seasaltsaige/popup-wink-mod/README.md

# Winkduino Headlight Controller

This project aims to be a "replacement" for the [MX-5 Tech](https://mx5tech.co.uk/wink-sleepy-eye-mod) Wink/Sleepy Eye mod. While, for most people, simply purchasing this product is the correct choice, as it is plug and play, this will aim to achieve the same result at a lower cost, but a bit more effort, though this reposity serves as a detailed guide on how to install the device in your own car, hopefully removing a lot of the difficulty. Plus it's a fun build :)

## See [OpenWink](https://github.com/seasaltsaige/openwink) now!

### DISCLAIMER:
This will modify, cut, and replace some of the cars wiring harness in the headlight motors. It is reversable, but not to 100% OEM standards. Do this at your own risk. I am not responsible for any damage you cause to your car or yourself.

This project will involve solder fumes. These are dangerous to inhale. Wear a mask and eye protection while soldering, and do it in a well ventalated area.

# Table of contents
[Getting Started](https://github.com/seasaltsaige/popup-wink-mod/blob/master/build/Home.md)

[Programming your Arduino](https://github.com/seasaltsaige/popup-wink-mod/blob/master/build/Code/Arduino/Programming.md)

[Installing your control App](https://github.com/seasaltsaige/popup-wink-mod/blob/master/build/Code/App/Installing.md)

[Start Building](https://github.com/seasaltsaige/popup-wink-mod/blob/master/build/Build/Home.md)

### [Check out the Gallery](https://github.com/seasaltsaige/popup-wink-mod/tree/master/build/images/Gallery/Gallery.md)
