seasaltsaige/popup-wink-mod/build/images/Materials.jpg

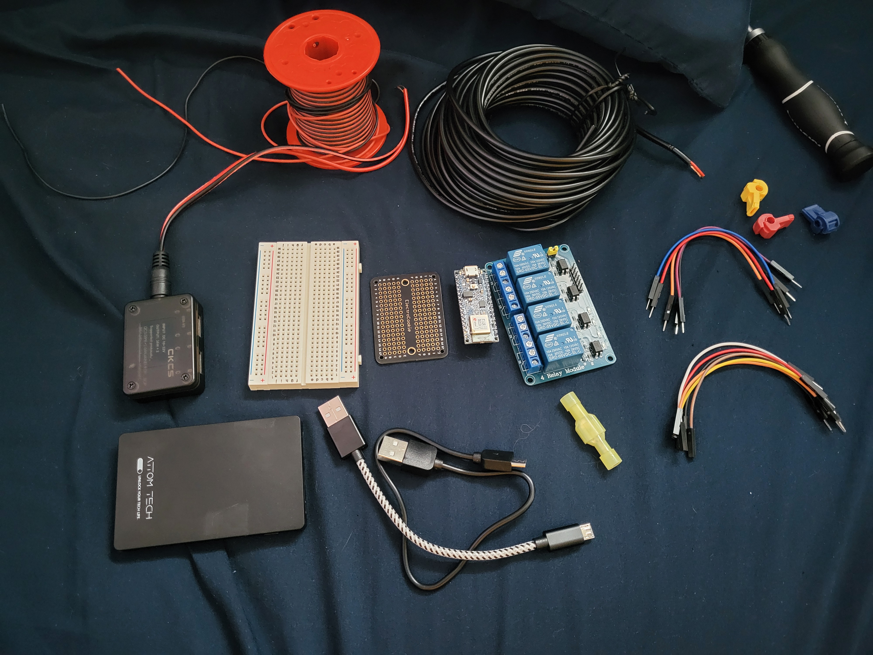
build/images/Materials.jpg
