seasaltsaige/popup-wink-mod/build/images/Gallery/Gallery.md

# Gallery
## App
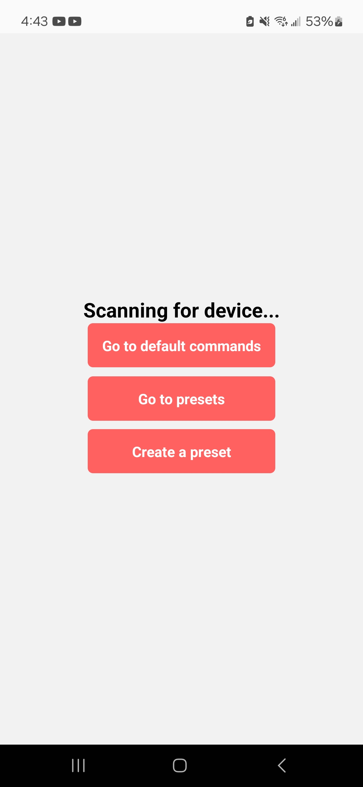
[picture p41: build/images/Gallery/ScanningHome.jpg]
HomeDisconnected

Landing page of the app. Displayed when no device is connected.

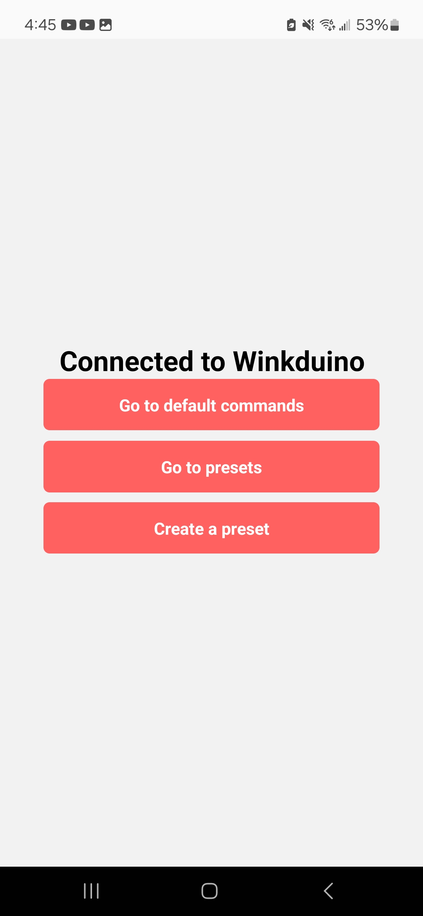
[picture p42: build/images/Gallery/HomeConnected.jpg]
HomeConnected

Landing page of the app. Displayed when Winkduino is connected.

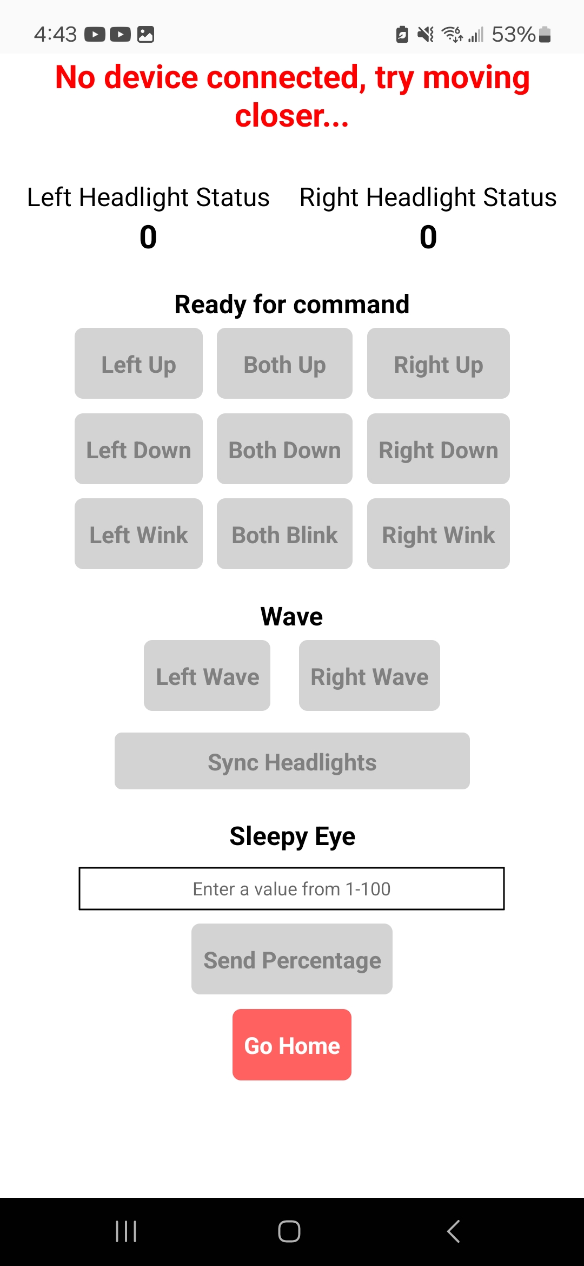
[picture p43: build/images/Gallery/NotConnectedDefault.jpg]
DefaultDisconnected

Default Commands when device is not connected

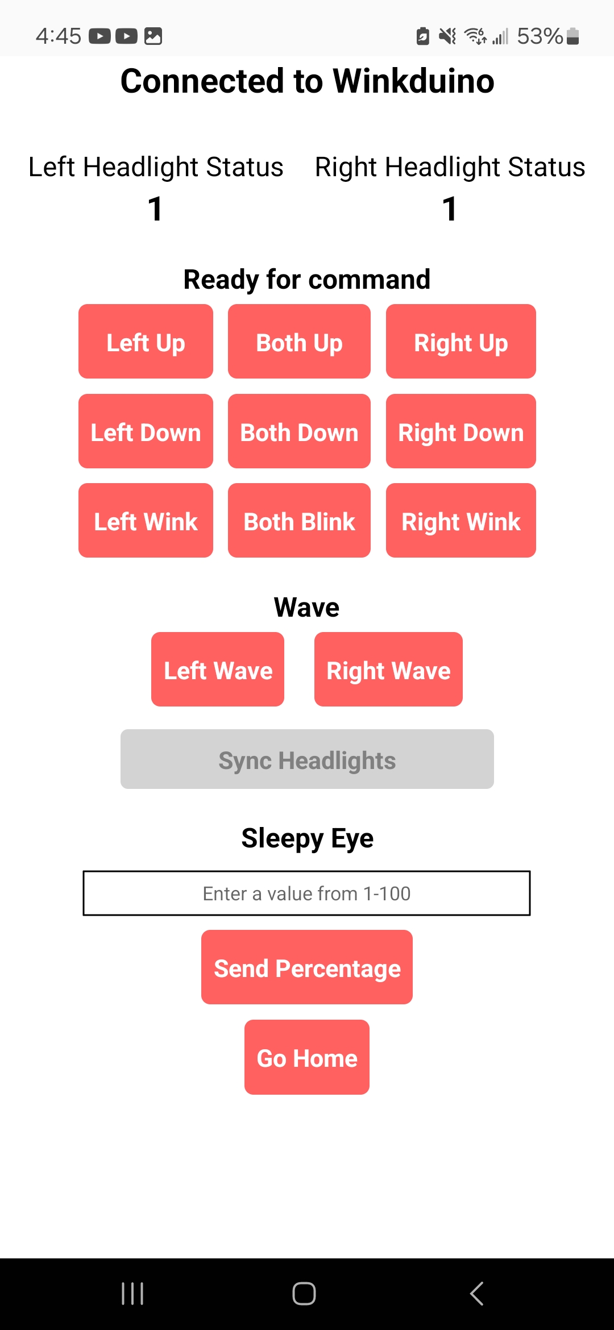
[picture p44: build/images/Gallery/DefaultConnected.jpg]
DefaultConnected

Default Commands when device IS connected

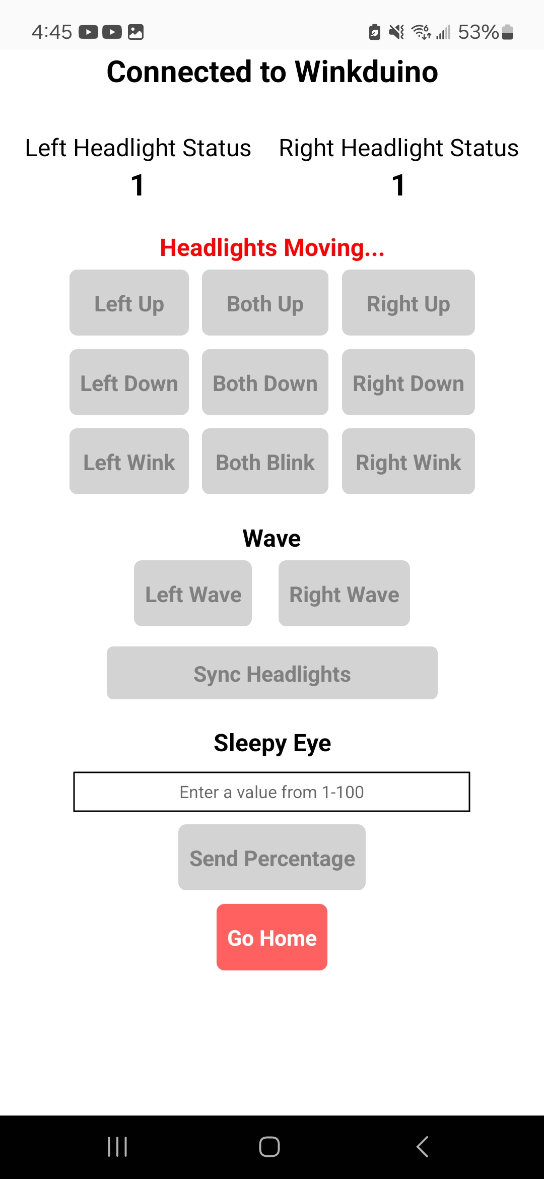
[picture p45: build/images/Gallery/DefaultMoving.jpg]
DefaultMoving

Default commands when headlights are moving

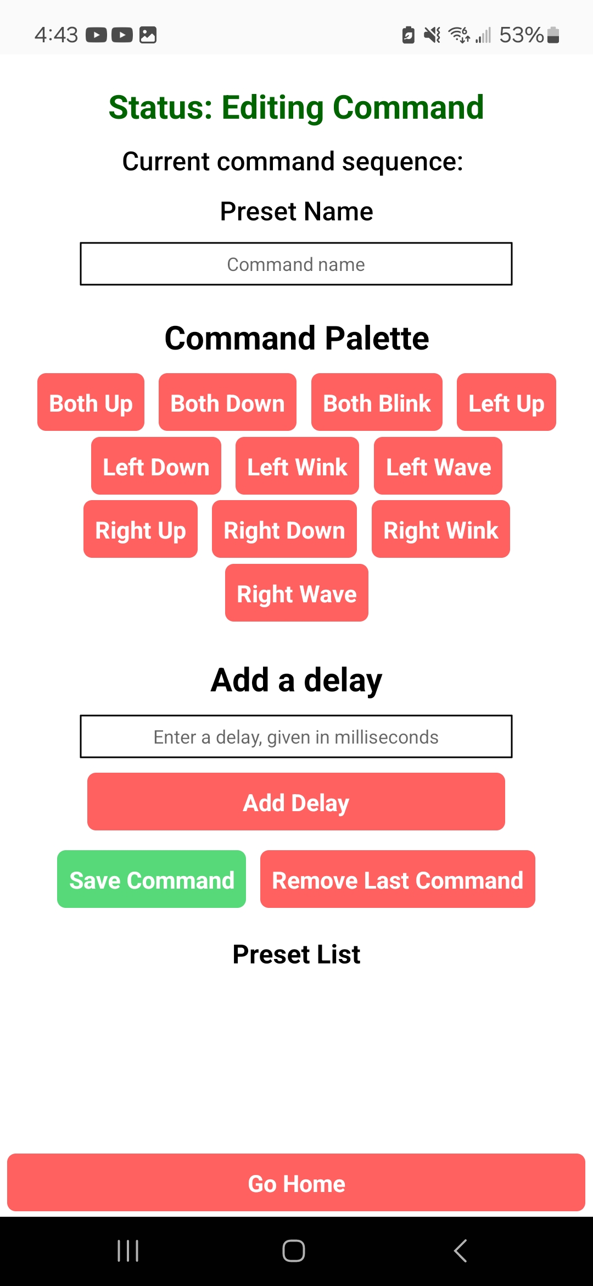
[picture p46: build/images/Gallery/CreatePresetEmpty.jpg]
CreatePreset

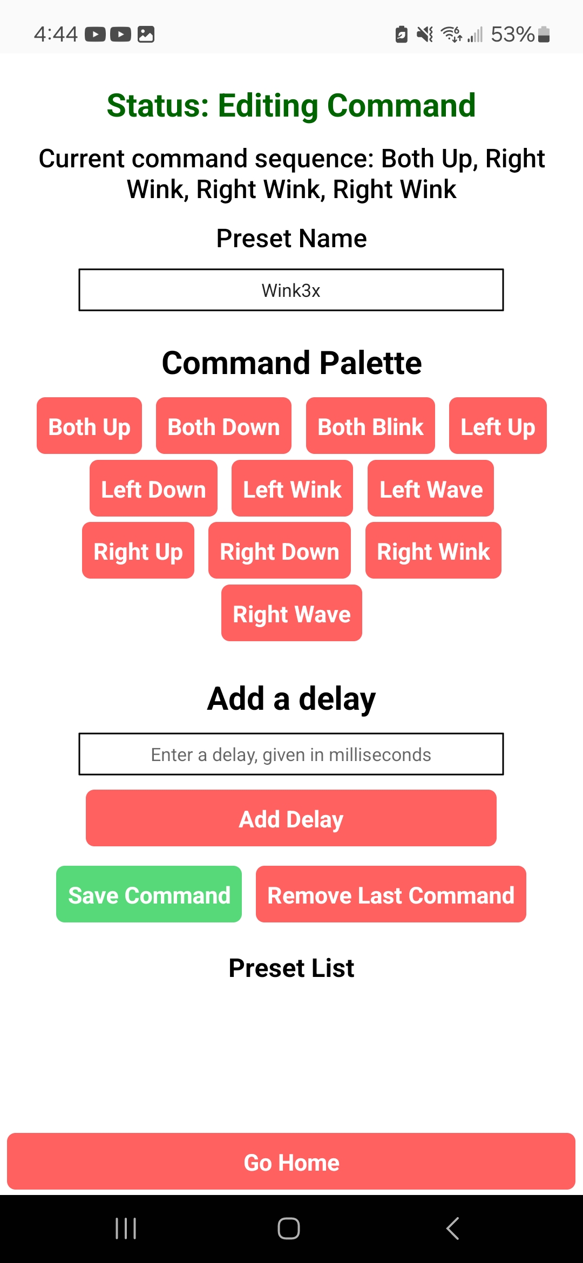
[picture p47: build/images/Gallery/CreatePresetFilled.jpg]
CreatePreset2

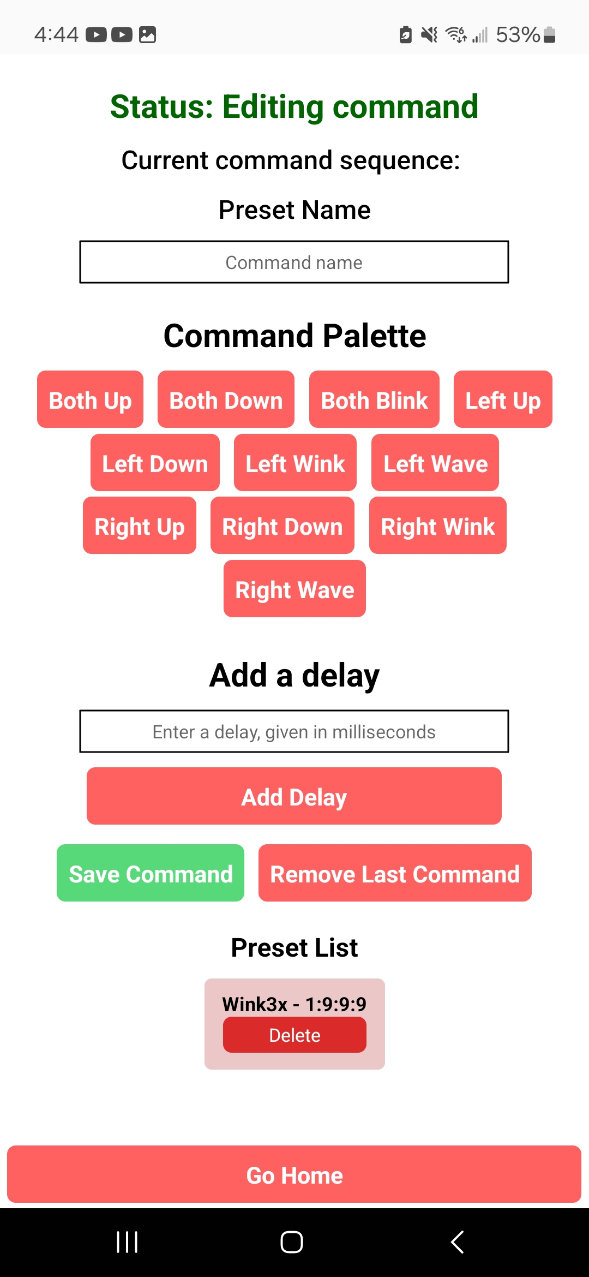
[picture p48: build/images/Gallery/PresetCreated.jpg]
CreatePreset3

Creating a preset, to be used as a shortcut, instead of pressing multiple default commands.

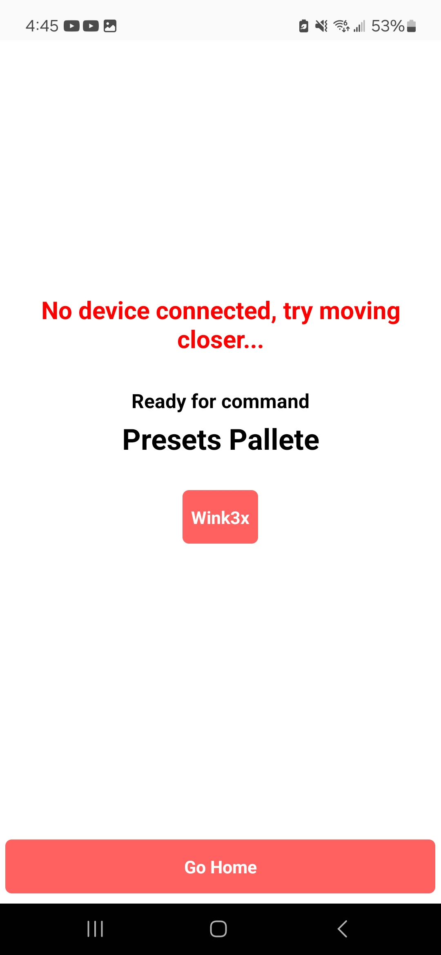
[picture p49: build/images/Gallery/PresetsNotConnected.jpg]
PresetsDisconnected

Presets pallete with no connection
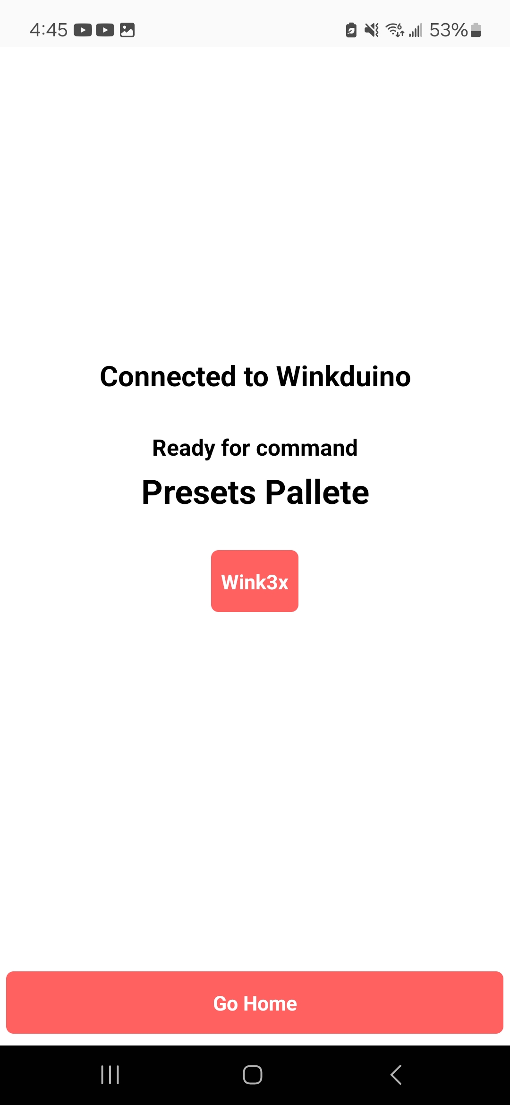
[picture p50: build/images/Gallery/ConnectedPresets.jpg]
Presets

Presets List

## Car
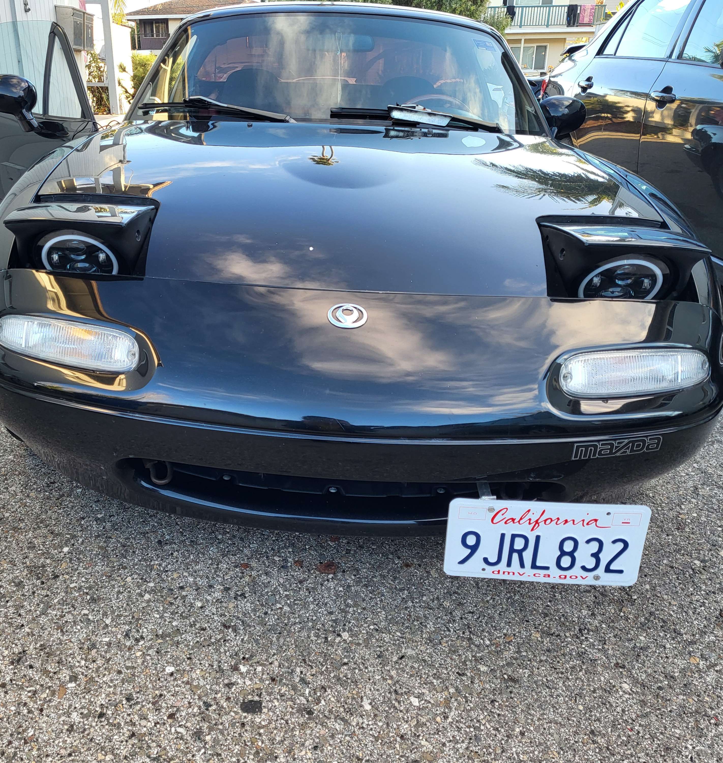
[picture p51: build/images/Gallery/Sleepy.jpg]
Sleepy


Wink
