seasaltsaige/popup-wink-mod/build/Code/Arduino/Programming.md

# Programming your Arduino

## Table of contents

- [Installing the Arduino IDE](#installing-the-arduino-ide)
- [Uploading the code](#uploading-the-code)
  - [Download](#download)
  - [Connection](#connection)
  - [Code overview](#code-overview)
    - [Download](#download-the-code)
    - [Modification](#modifying-the-code)
  - [Uploading to Board](#uploading-the-code)

## Installing the Arduino IDE

First, you will need to install the IDE that arduino provides. You can do so [here](https://www.arduino.cc/en/software)
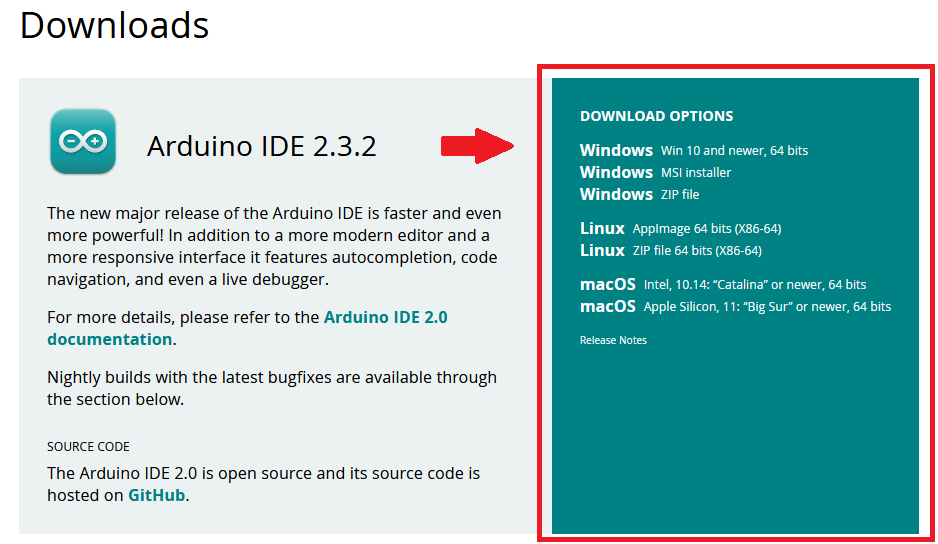
[picture p52: build/images/Arduino/Download.png]
IDE Download


## Connection
Once you have the IDE installed and open, you can go ahead and connect your Arduino to any USB port. The Arduino uses Micro USB-B as its connection.
The IDE should automatically detect it, and assign the correct COM port.
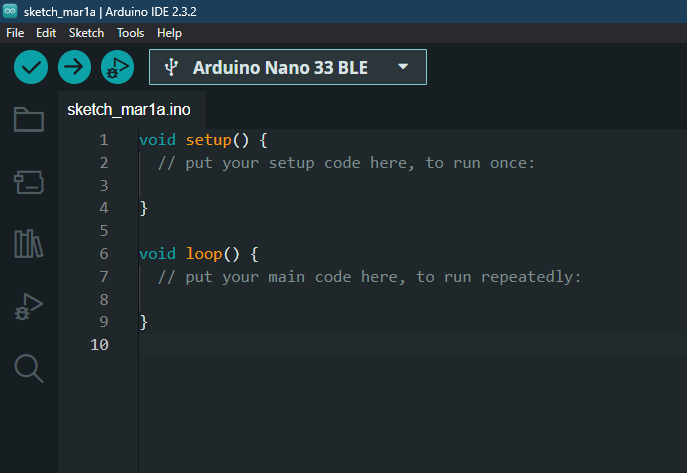
[picture p53: build/images/Arduino/IDE_1.png]
COM PORT


If it doesn't, you open the dropdown and select the Arduino. Make sure the COM Port is correct, otherwise the upload will fail.
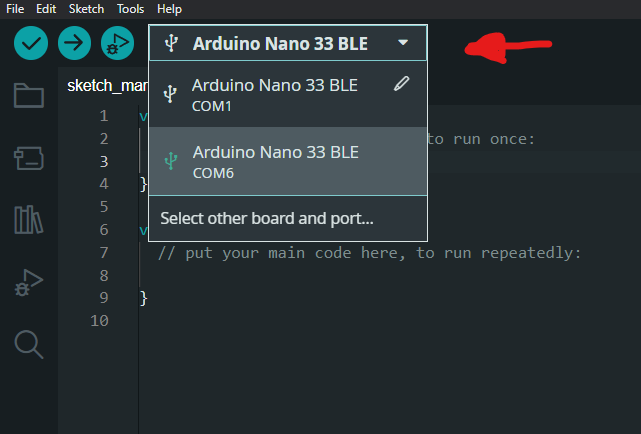
[picture p54: build/images/Arduino/IDE_2.png]
Selction


## Code overview

### Download the Code
To download the script that will be the main brains behind controlling the headlights, head to the [nano_ble](https://github.com/seasaltsaige/popup-wink-mod/blob/master/nano_ble/winkduino/winkduino.ino) folder, and click on the .ino file. In the top right of the code, there will be a "download raw" button. Download the file and save it to a folder with the same name as the file. (The IDE requires this.)

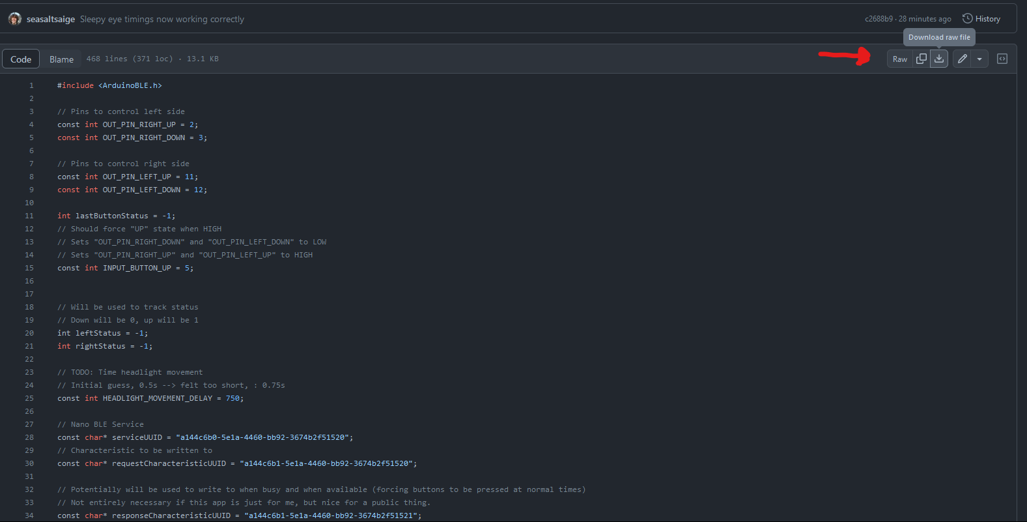
[picture p55: build/images/Arduino/DownloadCode.png]
Download Script


Once you have the script downloaded in its own folder, you can selected **File -> Open** in the Arduino IDE. Select the folder you just made.
You should be greeted with something along the lines of this.

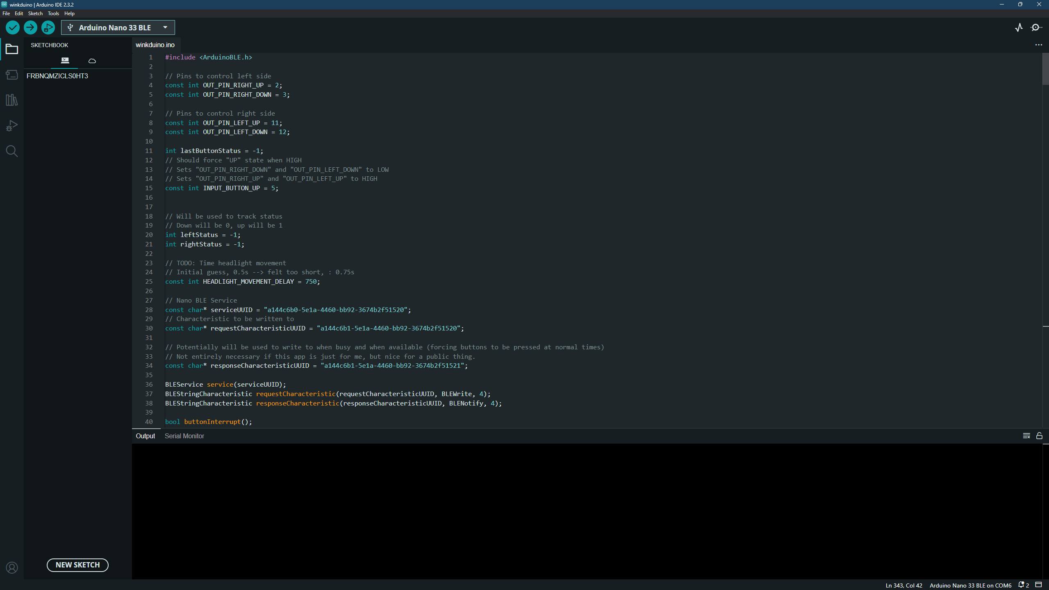
[picture p56: build/images/Arduino/MainCode.png]
Main Code


Well done! You're getting there.

Now we need to make sure that the ArduinoBLE library is installed, otherwise the program will not function.

On the left side of the IDE, you can click on the library manager, and search for "ArduinoBLE". Install this library.

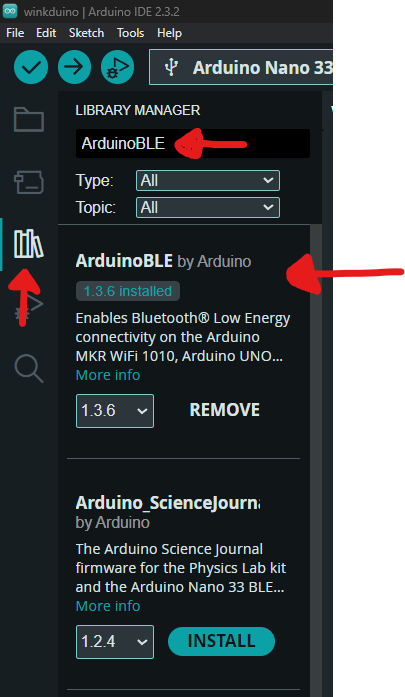
[picture p57: build/images/Arduino/BLELibrary.png]
BLE Library


Almost there!

### Modifying the code
If you feel you can, feel free to change the code however you see fit. Change the delays, change the pins used, change the whole thing if you want. This should serve as a starting point to make customizing it easy! (If you are able to modify this on your own, you likely don't need to be following the installation of the program on the arduino, and/or the App, so feel free to skip to the [Build Process](https://github.com/seasaltsaige/popup-wink-mod/tree/master/build/Build/Home.md))

## Uploading the code
Once you're ready, we can go ahead and upload the code to the arduino. To do this, all you need to do is press the right arrow in the top left of the screen.

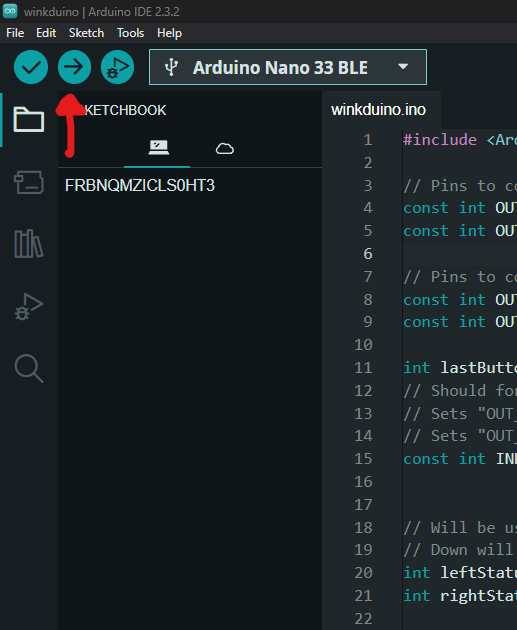
[picture p58: build/images/Arduino/UploadCode.png]
Upload


Congrats! Arduino programmed!

### [Go to App Installation -->](https://github.com/seasaltsaige/popup-wink-mod/tree/master/build/Code/App/Installing.md)
