seasaltsaige/popup-wink-mod/build/images/Build/Car/RadioConnector.jpg

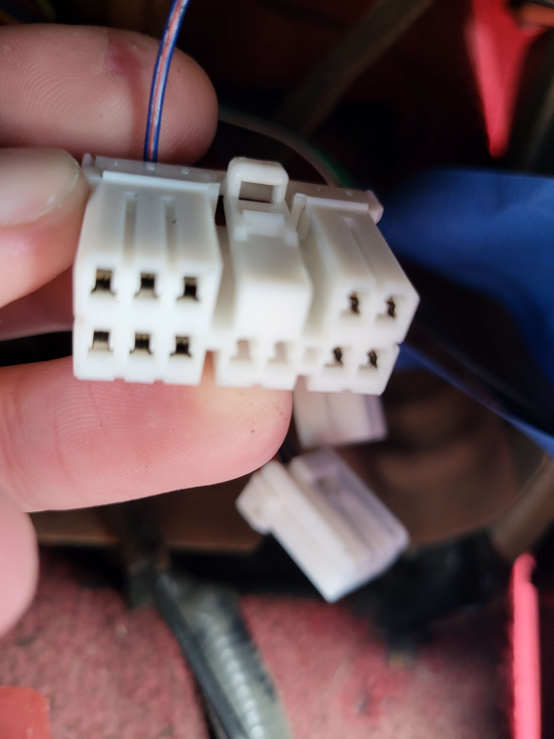
build/images/Build/Car/RadioConnector.jpg
