seasaltsaige/popup-wink-mod/build/images/Build/NanoBB.jpg

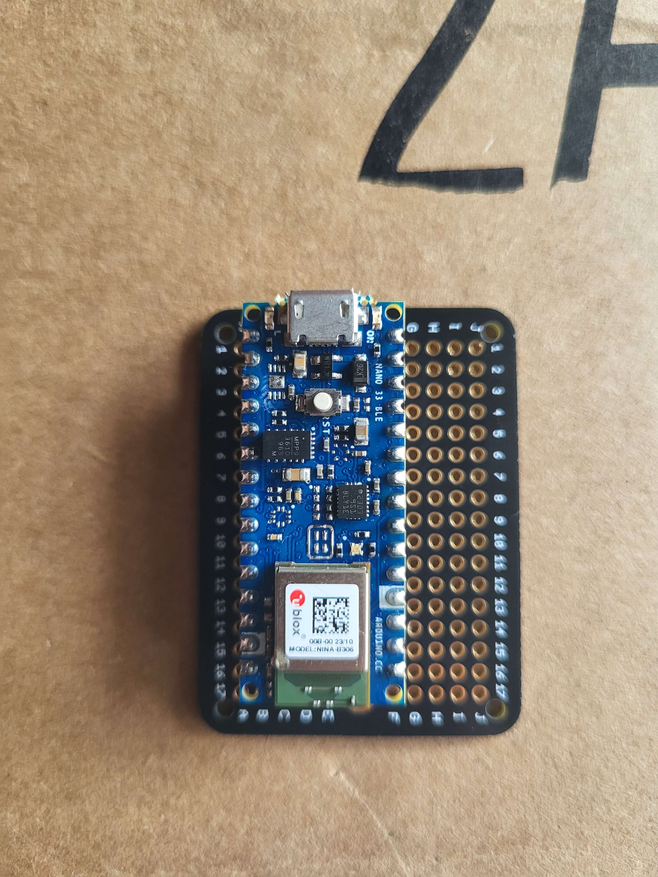
build/images/Build/NanoBB.jpg
