seasaltsaige/popup-wink-mod/build/images/Connectors.jpg

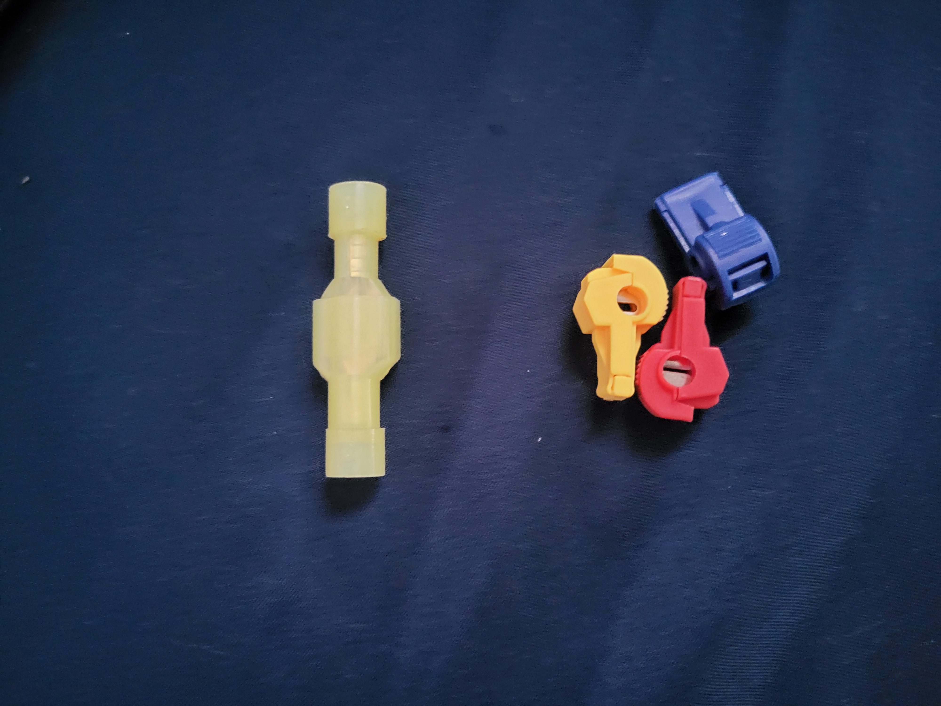
build/images/Connectors.jpg
