seasaltsaige/popup-wink-mod/build/images/Gallery/ScanningPresetsEmpty.jpg

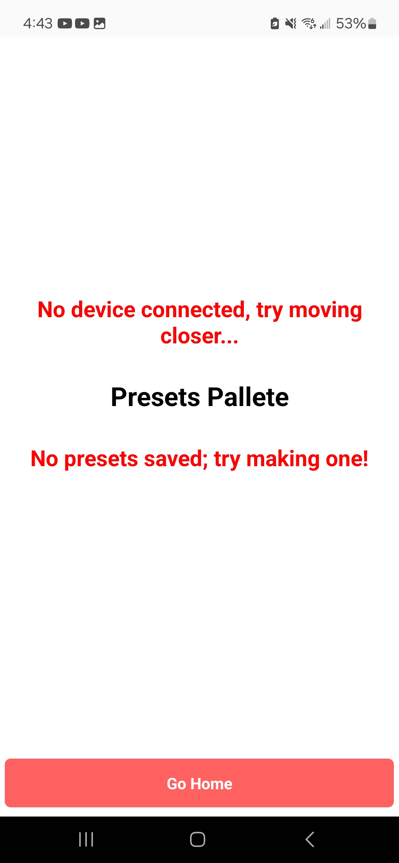
build/images/Gallery/ScanningPresetsEmpty.jpg
