seasaltsaige/popup-wink-mod/build/images/SolderlessBB.jpg

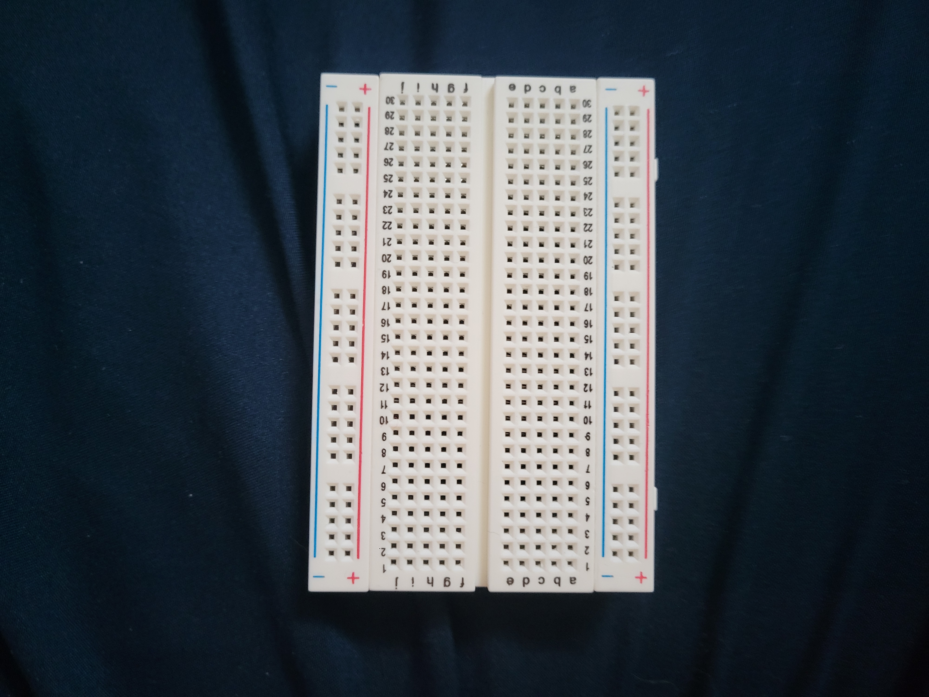
build/images/SolderlessBB.jpg
