seasaltsaige/popup-wink-mod/build/images/WIres1.jpg

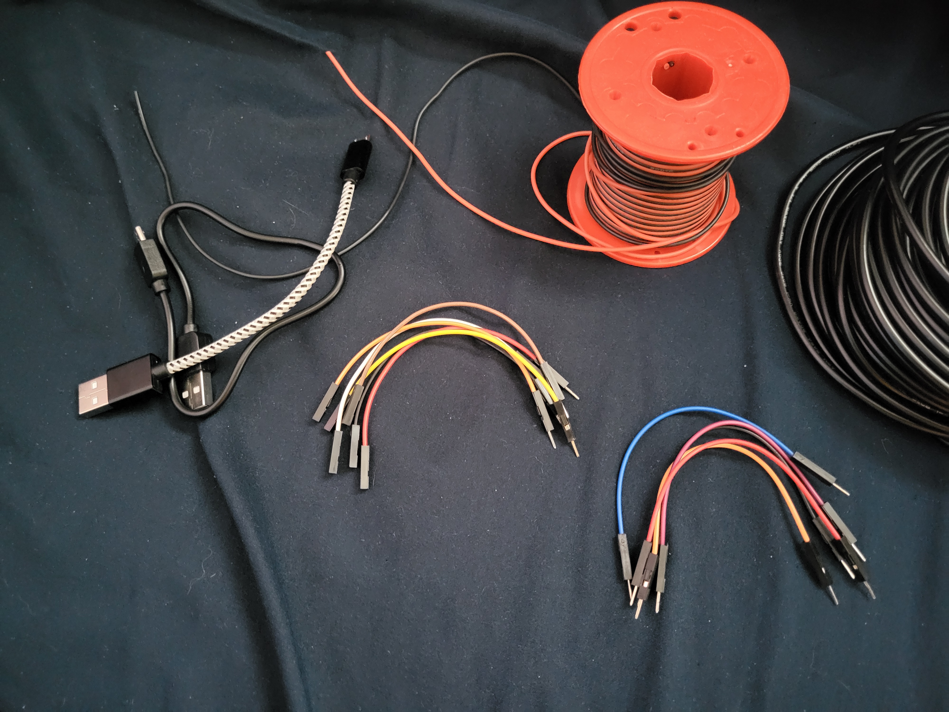
build/images/WIres1.jpg
