seasaltsaige/popup-wink-mod/(commit log)

2024-02-24 Boiler plate code + update to readme
2024-02-26 Nano Code work. Can't test until board arrives
2024-02-28 Work done on arduino code. Still waiting on board
2024-02-28 Update syncHeadlights to account for main button. Added case for potential sleepy eyes
2024-02-29 Major work on app side. Development build ready for testing when arduino arrives
2024-03-01 Massive work done on arduino code. Most works at this moment.
2024-03-01 swapped pin values as they were backwards
    [winkduino.ino]
2024-03-01 Work on sleepy eye, but relays are not cooperating
2024-03-01 Sleepy eye timings now working correctly
    [winkduino.ino]
2024-03-01 Got sleepy eye reset working, as to avoid destroying motors
    [winkduino.ino]
2024-03-03 radio wiring harness docs
2024-03-08 Update materials
2024-03-10 Presets on arduino end working
