seasaltsaige/popup-wink-mod/build/images/CatBreak2.jpg

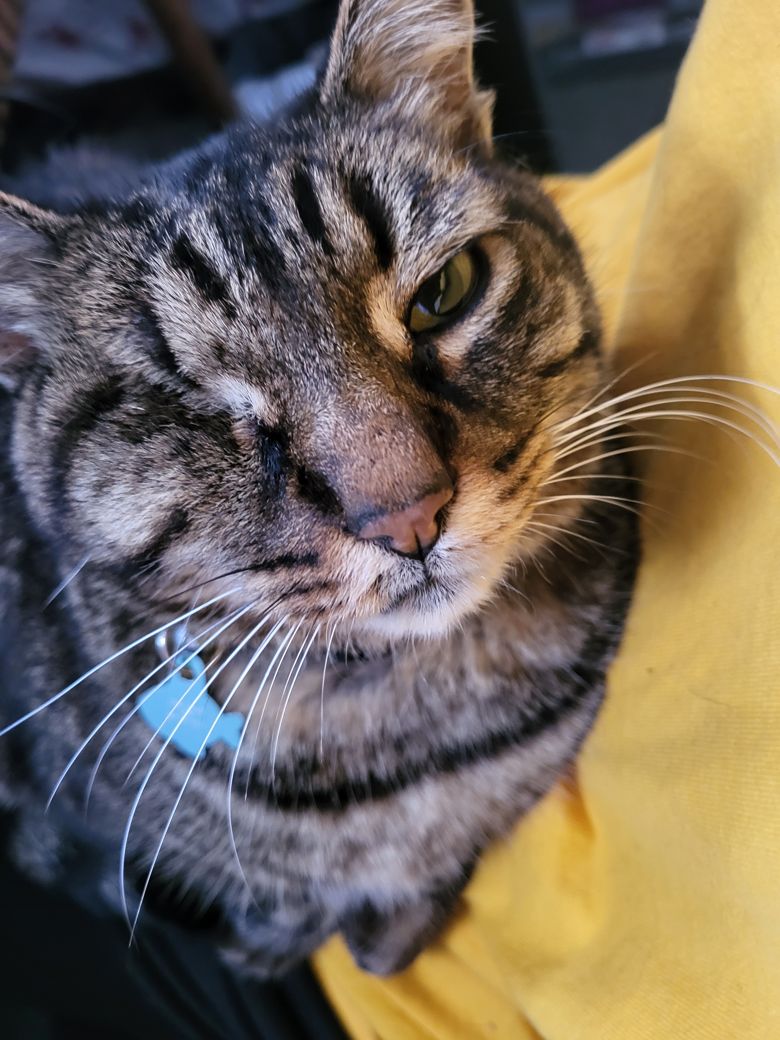
[picture p9: build/images/CatBreak2.jpg]
build/images/CatBreak2.jpg
