seasaltsaige/popup-wink-mod/build/images/Build/RelayOutputWiredFull.jpg

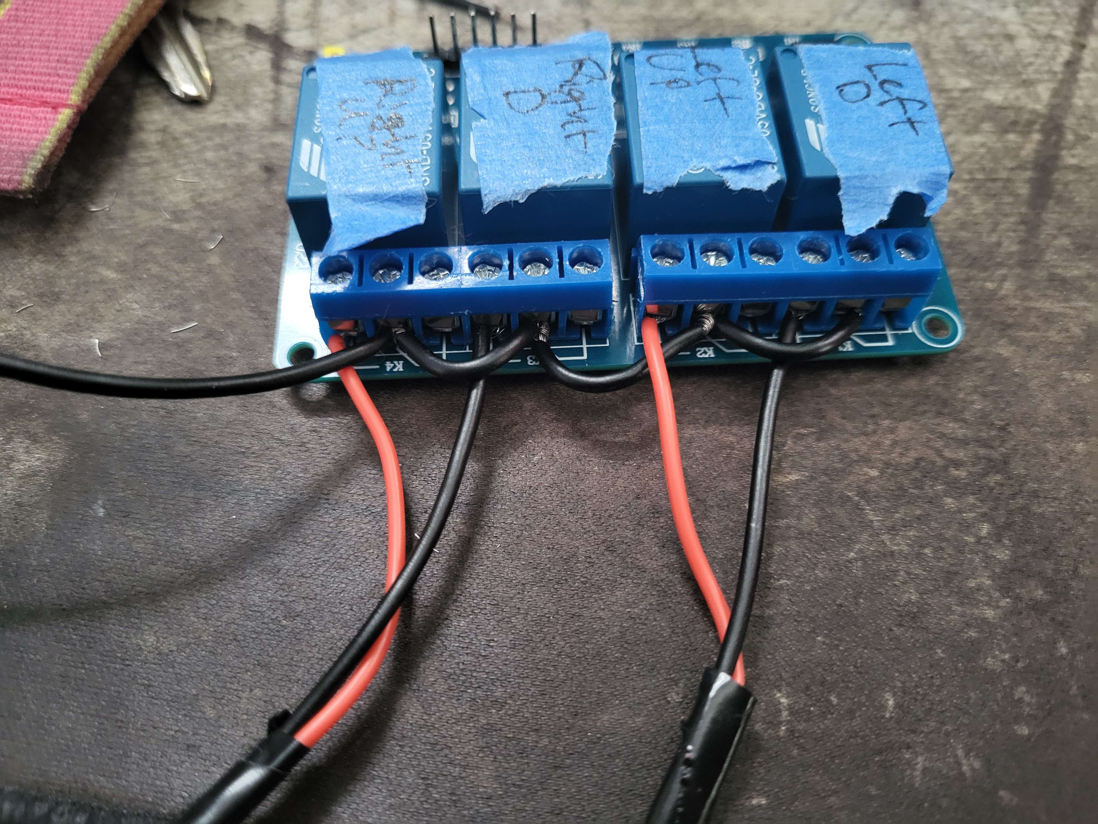
[picture p17: build/images/Build/RelayOutputWiredFull.jpg]
build/images/Build/RelayOutputWiredFull.jpg
