seasaltsaige/popup-wink-mod/build/images/20240229_184129.jpg

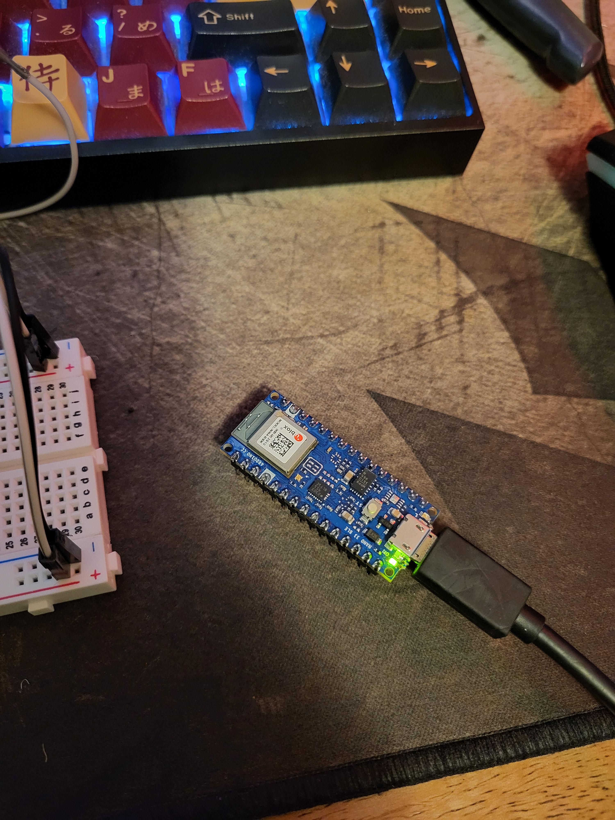
build/images/20240229_184129.jpg
