seasaltsaige/popup-wink-mod/build/images/20240229_211233.jpg

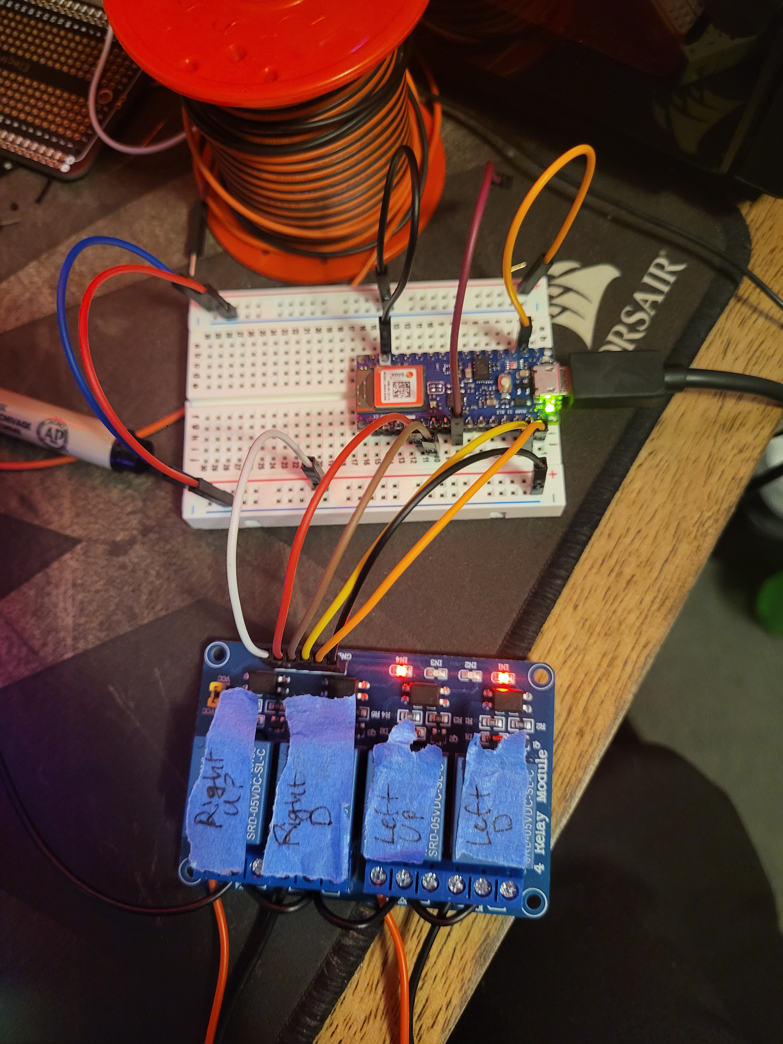
build/images/20240229_211233.jpg
