seasaltsaige/popup-wink-mod/build/images/20240301_091802.jpg

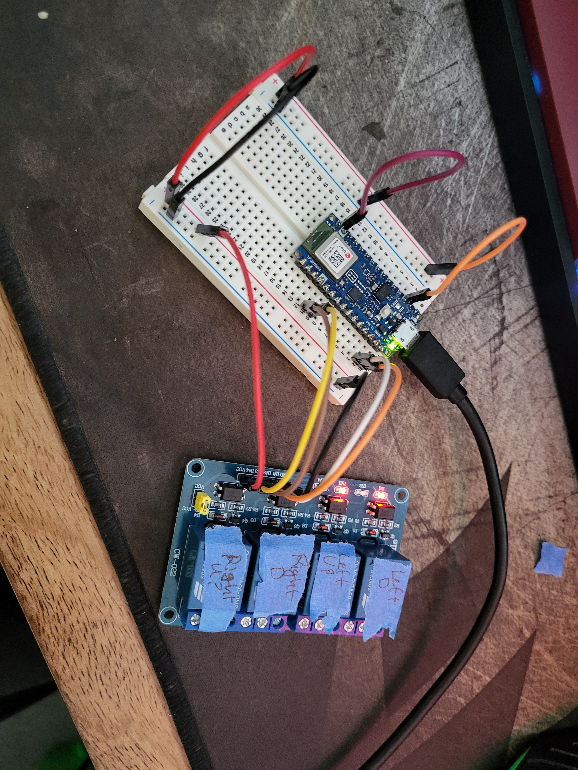
build/images/20240301_091802.jpg
