seasaltsaige/popup-wink-mod/build/images/BreadBoardConnections.jpg

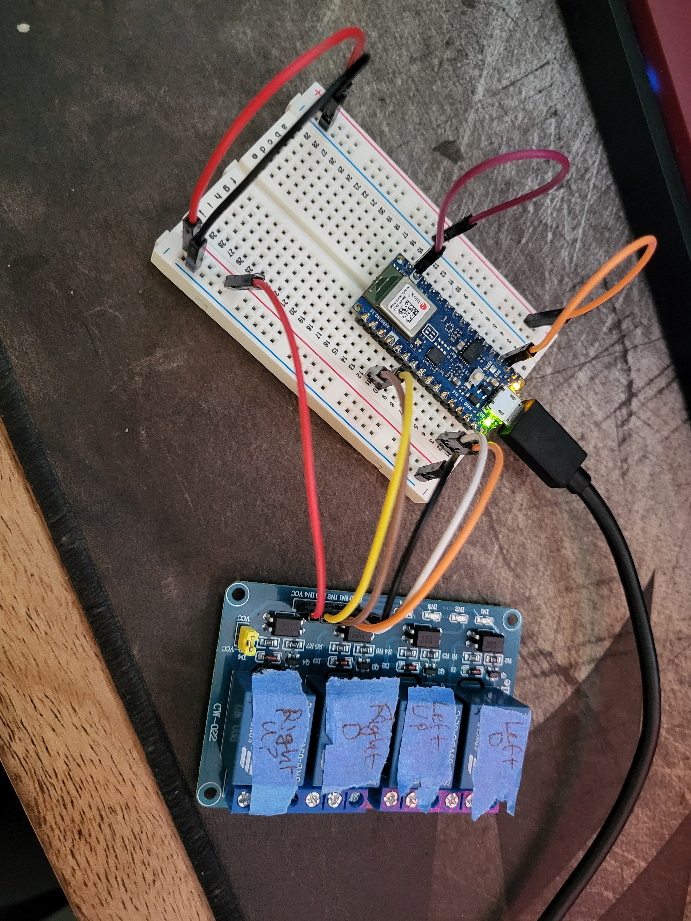
build/images/BreadBoardConnections.jpg
