seasaltsaige/popup-wink-mod/build/images/CatBreak.jpg

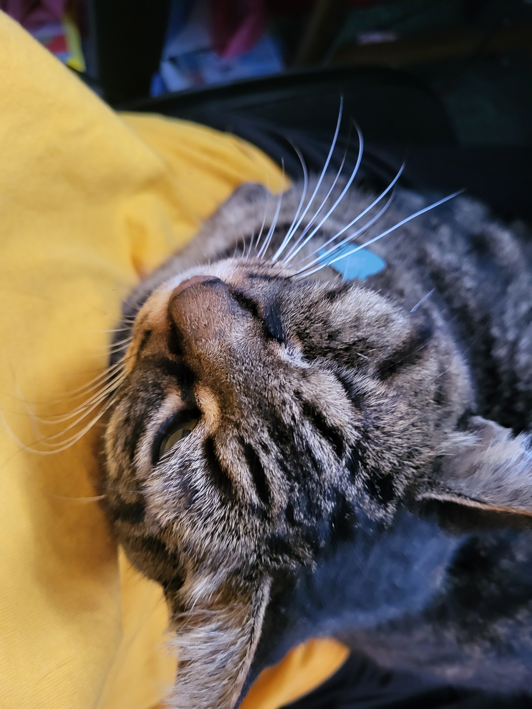
build/images/CatBreak.jpg
