seasaltsaige/popup-wink-mod/build/images/TopDown.jpg

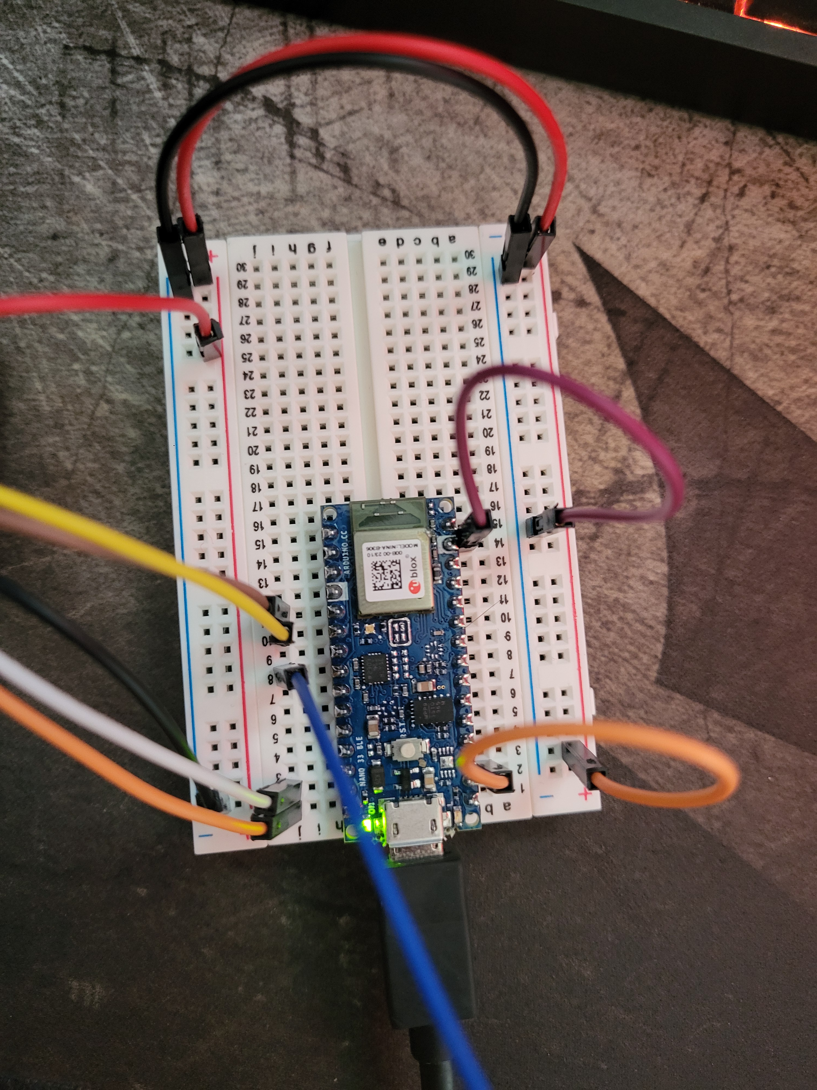
build/images/TopDown.jpg
